madcatse/snark-barker/dxf/SnarkBarker-Edge_Cuts.dxf

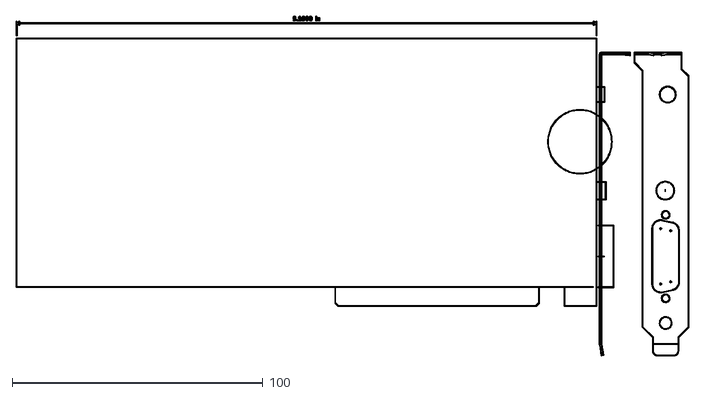
[picture p1: CAD file, 2024-10-25]
dxf/SnarkBarker-Edge_Cuts.dxf
268.1 x 135.3
