madcatse/snark-barker/SnarkBarker.kicad_pcb

## KiCad design SnarkBarker.kicad_pcb (2026-02-19)

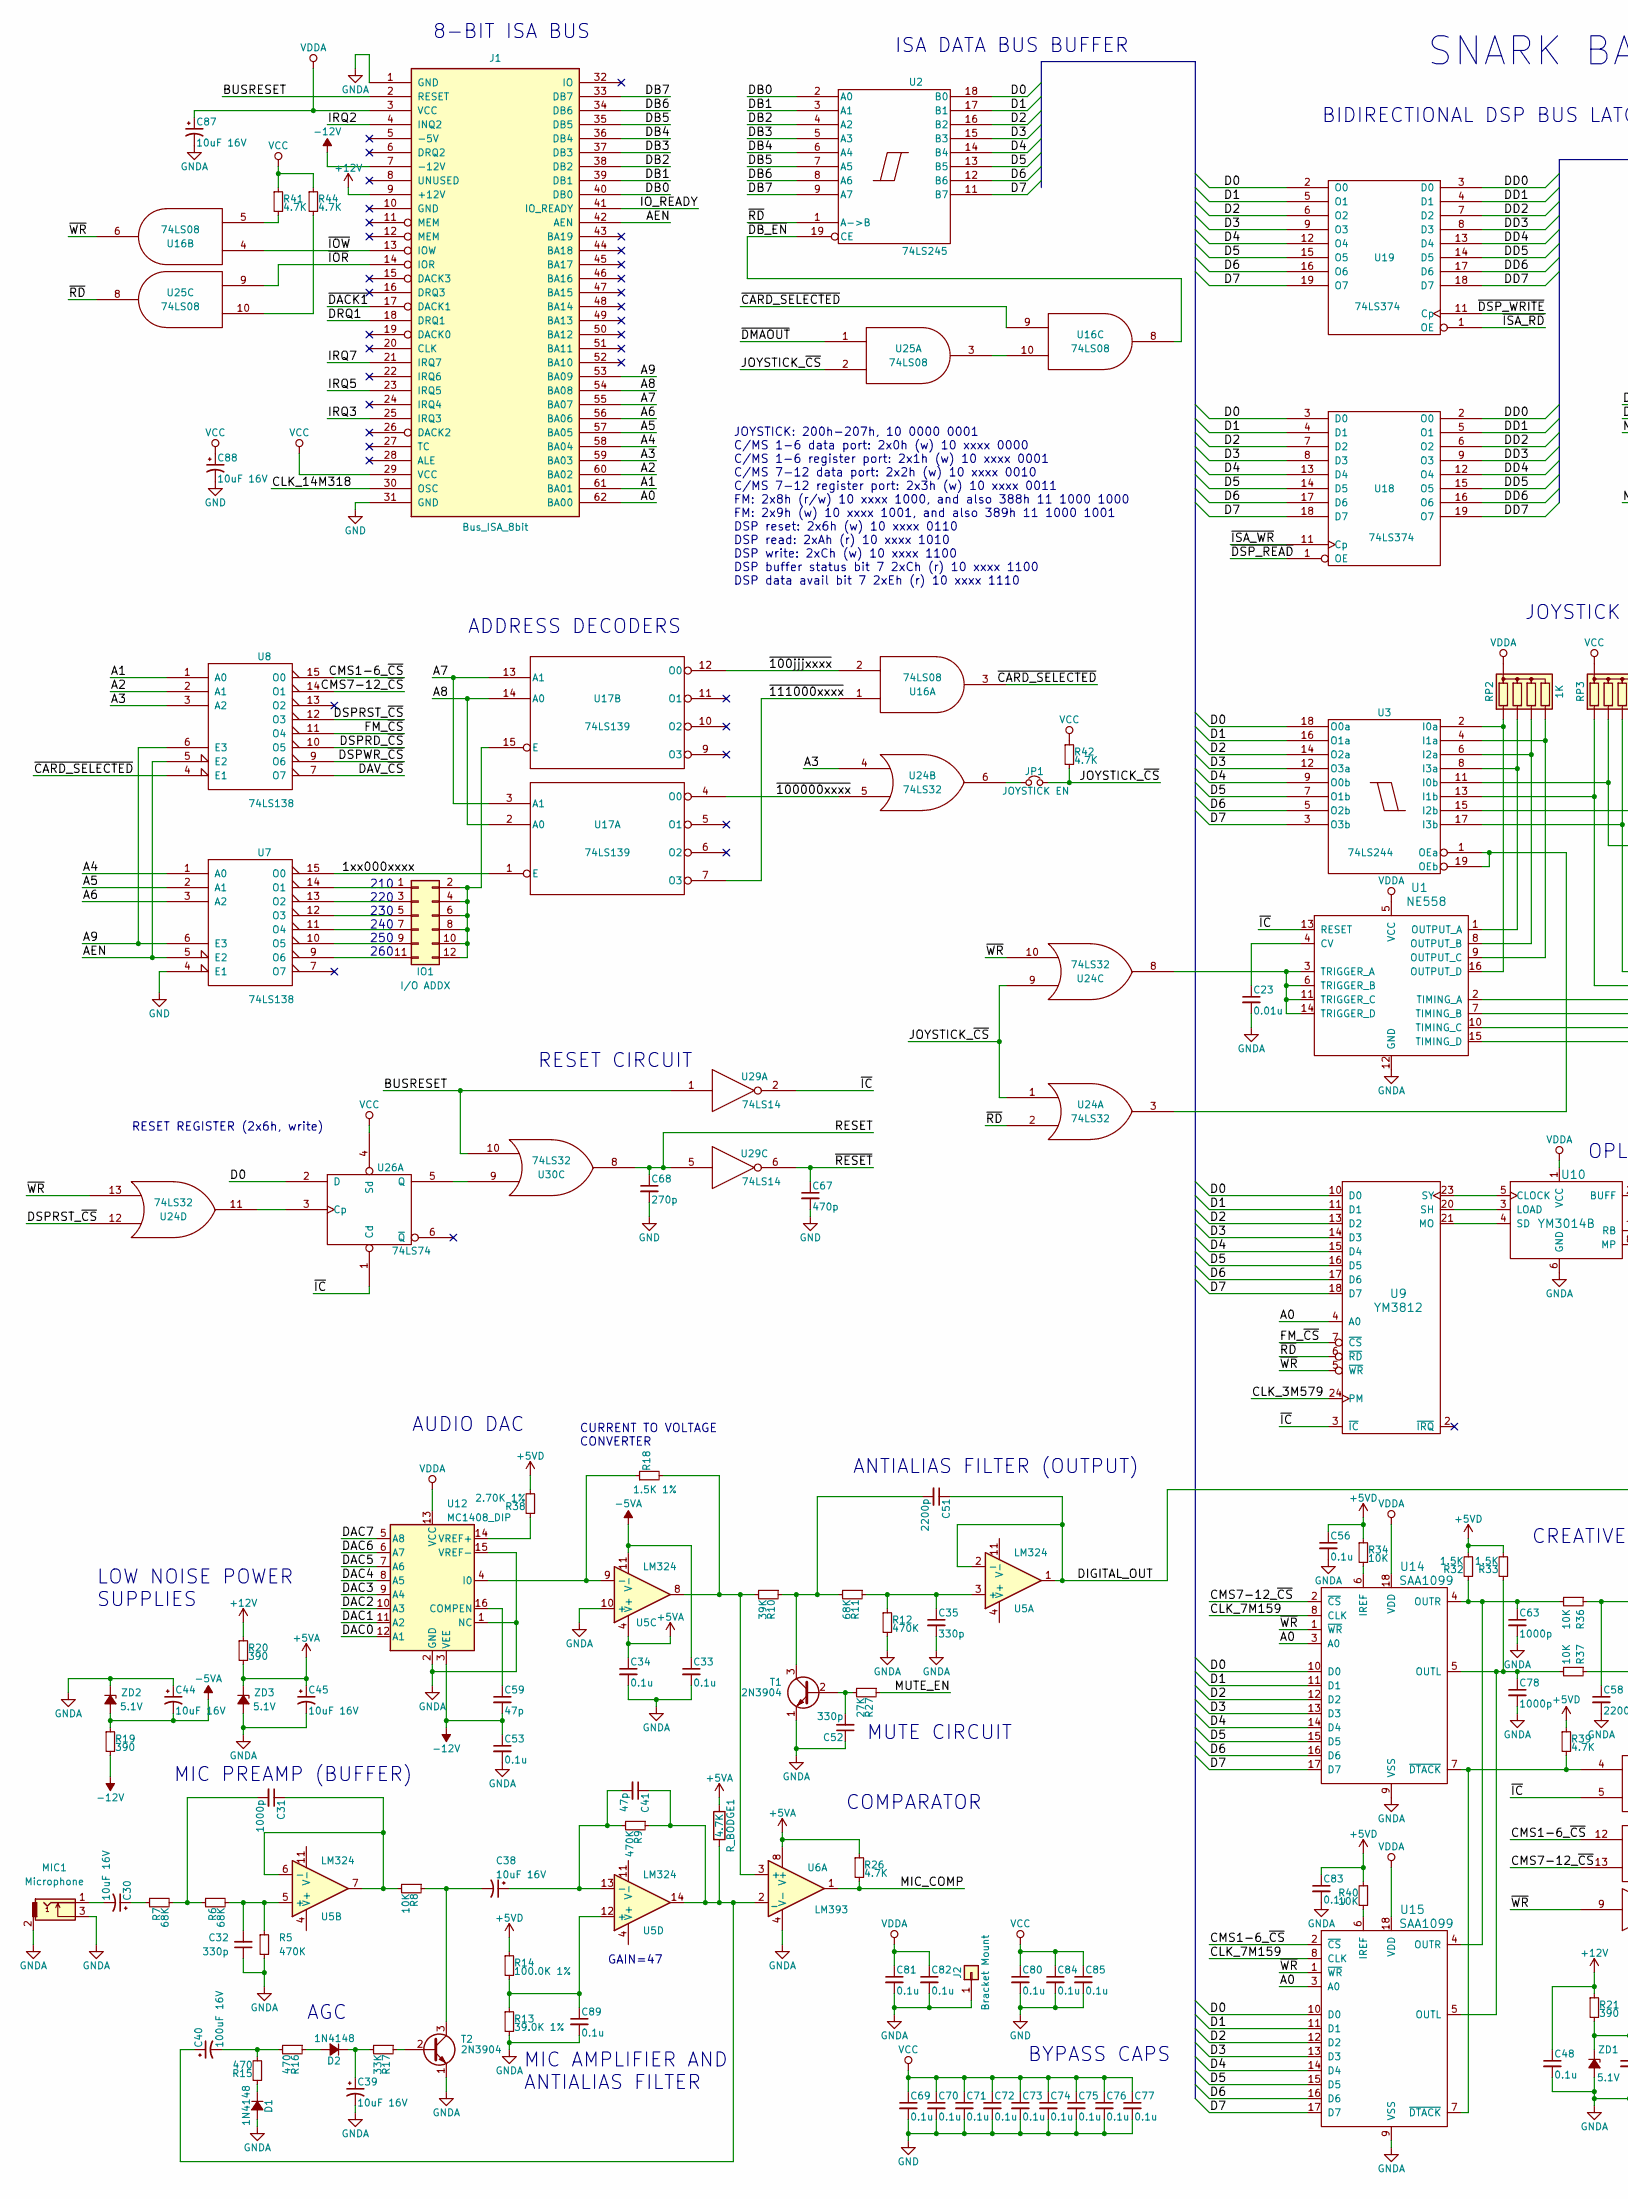
[picture p2: schematic SnarkBarker.kicad_sch, part in row 1, column 1]

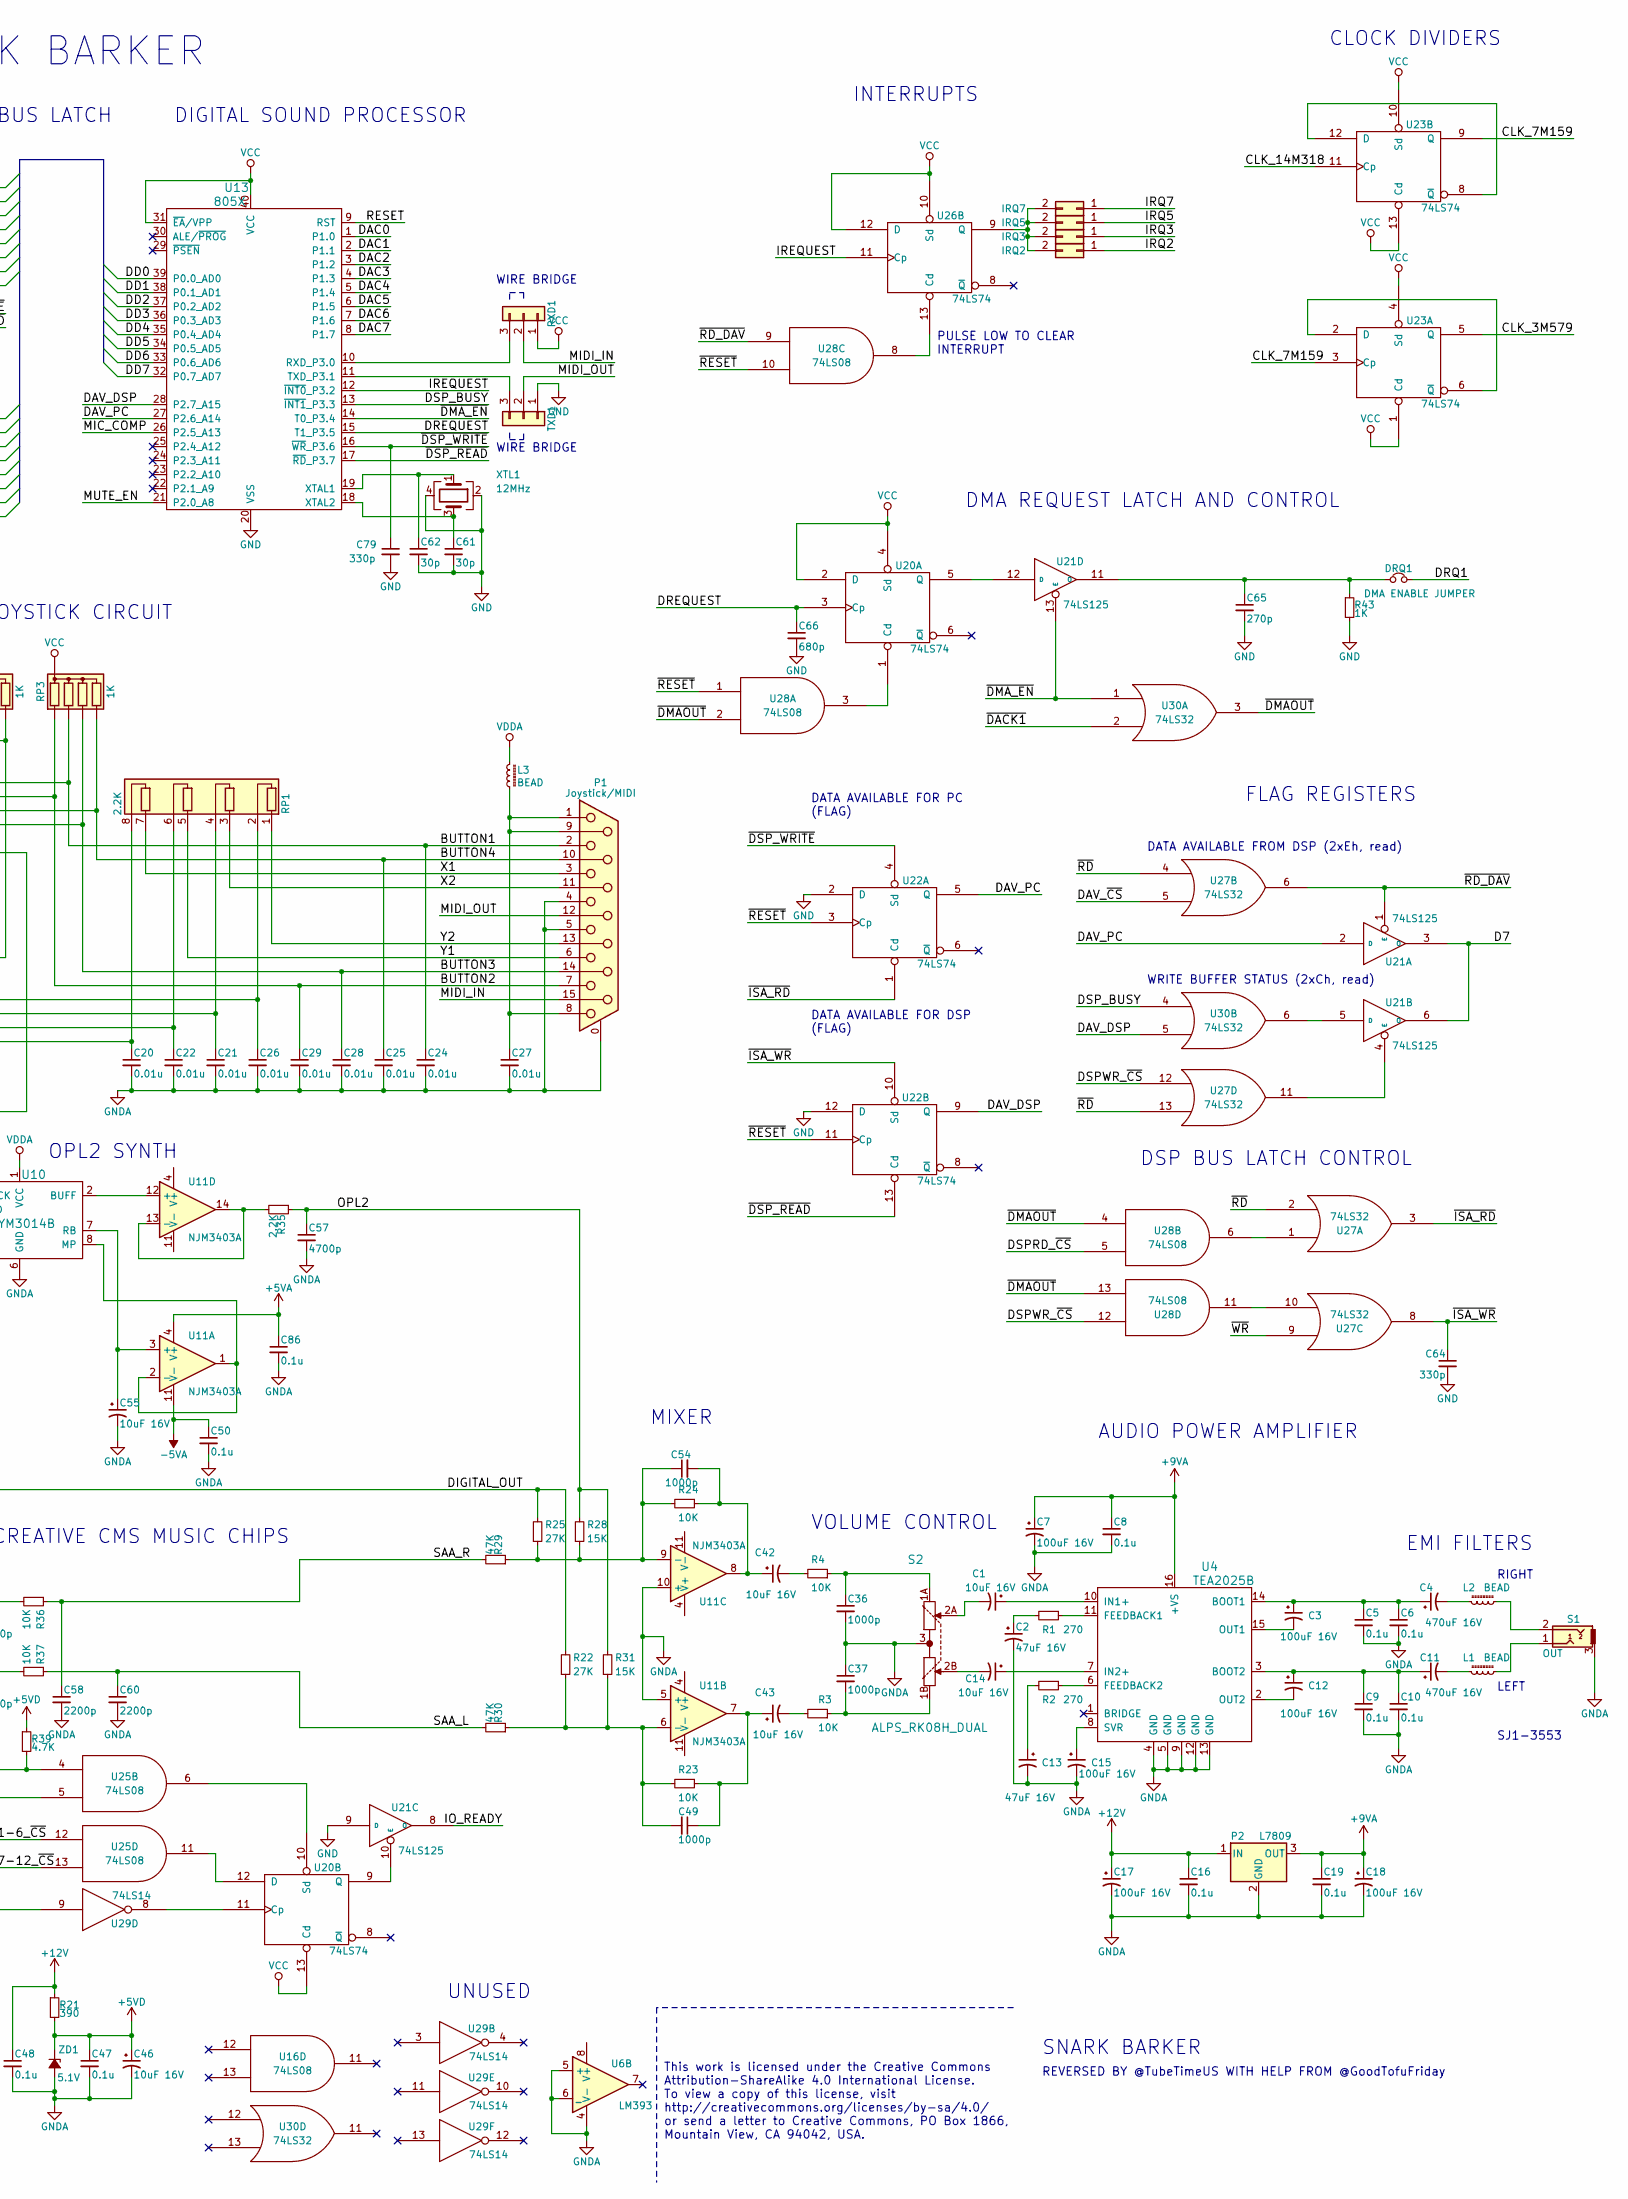
[picture p3: schematic SnarkBarker.kicad_sch, part in row 1, column 2]

Parts:
C1, C14, C30, C38, C39, C42, C43, C44, C45, C46, C55, C87, C88: 10uF 16V; SB_C_RADIAL_75_150; Mouser 667-ECA-1CM100I
C2, C13: 47uF 16V; SB_C_RADIAL_75_150; Mouser 667-ECA-1CM470I
C3, C7, C12, C15, C17, C18, C40: 100uF 16V; SB_C_RADIAL_100_320; Mouser 667-ECA-1CM101I
C4, C11: 470uF 16V; SB_C_RADIAL_100_320; Mouser 667-ECA-1CM471B
C5, C6, C8, C9, C10, C16, C19, C33, C34, C47, C48, C50, C53, C56, C69, C70, C71, C72, C73, C74, C75, C76, C77, C80, C81, C82, C83, C84, C85, C86, C89: 0.1u; SB_C_AXIAL_275; Mouser 581-SA105E104M
C20, C21, C22, C23, C24, C25, C26, C27, C28, C29: 0.01u; SB_C_DISC_200; Mouser 810-FG28X7R1H103KNT0
C31, C36, C37, C49, C54, C63, C78: 1000p; SB_C_DISC_200; Mouser 810-FG28X7R1H102KNT6
C32, C35, C52, C64, C79: 330p; SB_C_DISC_200; Mouser 810-FG28C0G1H331JNT6
C41, C59: 47p; SB_C_DISC_200; Mouser 810-FG28C0G1H470JNT6
C51, C58, C60: 2200p; SB_C_DISC_200; Mouser 810-FG28X7R1H222KNT6
C57: 4700p; SB_C_DISC_200; Mouser 810-FG28C0G1H472JNT6
C61, C62: 30p; SB_C_DISC_200; Mouser 810-FG28C0G1H270JNT6
C65, C68: 270p; SB_C_DISC_200; Mouser 810-FG28C0G1H271JNT0
C66: 680p; SB_C_DISC_200; Mouser 810-FG28C0G1H681JNT6
C67: 470p; SB_C_DISC_200; Mouser 810-FG28C0G1H471JNT6
D1, D2: 1N4148; SB_D_AXIAL_400; Mouser 512-1N4148
DRQ1: DMA ENABLE JUMPER; SB_HDR_1X2
IO1: I/O ADDX; SB_HDR_2X6
IRQ2, IRQ3, IRQ5, IRQ7: Conn_02x01; SB_HDR_1X2
J1: Bus_ISA_8bit; BUS_PC
J2: Bracket Mount; SB_MH_125; Mouser 534-9200
JP1: JOYSTICK EN; SB_HDR_1X2
L1, L2, L3: BEAD; SB_L_AXIAL_500; Mouser 623-2743004111
MIC1: Microphone; SB_MJ-3536N; Mouser 490-MJ-3536N
P1: Joystick/MIDI; SB_DB15_152-3415; Mouser 1636-182-015-213R53
P2: L7809; SB_TO220; Mouser 511-L7809CV
R1, R2: 270; SB_R_AXIAL_400; Mouser 603-CFR-25JB-52-270R
R3, R4, R8, R23, R24, R34, R36, R37, R40: 10K; SB_R_AXIAL_400; Mouser 603-CFR-25JB-52-10K
R5, R9, R12: 470K; SB_R_AXIAL_400; Mouser 603-CFR-25JR-52470K
R6, R7, R11: 68K; SB_R_AXIAL_400; Mouser 603-CFR-25JB-52-68K
R10: 39K; SB_R_AXIAL_400; Mouser 603-CFR-25JB-52-39K
R13: 39.0K 1%; SB_R_AXIAL_400; Mouser 603-MFR-25FBF52-39K
R14: 100.0K 1%; SB_R_AXIAL_400; Mouser 603-MFR-25FBF52-100K
R15, R16: 470; SB_R_AXIAL_400; Mouser 603-CFR-25JB-52-470R
R17: 33K; SB_R_AXIAL_400; Mouser 603-CFR-25JB-52-33K
R18: 1.5K 1%; SB_R_AXIAL_400; Mouser 603-MFR-25FBF52-1K5
R19, R20, R21: 390; SB_R_AXIAL_400; Mouser 603-CFR-25JB-52-390R
R22, R25, R27: 27K; SB_R_AXIAL_400; Mouser 603-CFR-25JB-52-27K
R26, R39, R41, R42, R44: 4.7K; SB_R_AXIAL_400; Mouser 603-CFR-25JB-52-4K7
R28, R31: 15K; SB_R_AXIAL_400; Mouser 603-CFR-25JB-52-15K
R29, R30: 47K; SB_R_AXIAL_400; Mouser 603-CFR-25JB-52-47K
R32, R33: 1.5K; SB_R_AXIAL_400; Mouser 603-CFR-25JB-52-1K5
R35: 2.2K; SB_R_AXIAL_400; Mouser 603-CFR-25JB-52-2K2
R38: 2.70K 1%; SB_R_AXIAL_400; Mouser 603-MFR-25FBF52-2K7
R43: 1K; SB_R_AXIAL_400; Mouser 603-CFR-25JR-521K
RP1: 2.2K; SB_RP_4B; Mouser 652-4608X-AP2-222LF
RP2, RP3: 1K; SB_RP_4C; Mouser 652-4605X-AP1-102LF
RXD1: Conn_01x03; SB_HDR_1X3
R_BODGE1: 4.7K; Mouser 603-CFR-25JB-52-4K7
S1: OUT; SB_SJ1-3553; Mouser 490-SJ1-3553NG
S2: ALPS_RK08H_DUAL; SB_ALPS_RK08_DUAL; Mouser 688-RK08H12100F3
T1, T2: 2N3904; SB_TO92; Mouser 833-2N3904-AP
TXD1: Conn_01x03; SB_HDR_1X3
U1: NE558; SB_DIP16_300
U2: 74LS245; SB_DIP20_300; Mouser 595-SN74LS245N
U3: 74LS244; SB_DIP20_300; Mouser 595-SN74LS244N
U4: TEA2025B; SB_DIP16_300
U5: LM324; SB_DIP14_300; Mouser 595-LM324AN
U6: LM393; SB_DIP8_300; Mouser 595-LM393P
U7, U8: 74LS138; SB_DIP16_300; Mouser 595-SN74LS138NE4
U9: YM3812; SB_DIP24_600
U10: YM3014B; SB_DIP8_300
U11: NJM3403A; SB_DIP14_300; Mouser 513-NJM3403AD
U12: MC1408_DIP; SB_DIP16_300; Mouser 926-DAC0808LCN/NOPB
U13: 805X; SB_DIP40_600; Mouser 556-A89S51-24PU
U14, U15: SAA1099; SB_DIP18_300
U16, U25, U28: 74LS08; SB_DIP14_300; Mouser 595-SN74LS08N
U17: 74LS139; SB_DIP16_300; Mouser 595-SN74LS139AN
U18, U19: 74LS374; SB_DIP20_300; Mouser 595-SN74LS374N
U20, U22, U23, U26: 74LS74; SB_DIP14_300; Mouser 595-SN74LS74AN
U21: 74LS125; SB_DIP14_300; Mouser 595-SN74LS125AN
U24, U27, U30: 74LS32; SB_DIP14_300; Mouser 595-SN74LS32N
U29: 74LS14; SB_DIP14_300; Mouser 595-SN74LS14N
XTL1: 12MHz; SB_XTAL_HC49U_RA; Mouser 815-AB-12-B2
ZD1, ZD2, ZD3: 5.1V; SB_D_AXIAL_400_ALT; Mouser 78-1N5231B-TAP

Connections:
+5VA: C34.1, C45.1, C86.1, R20.2, R26.1, R_BODGE1.1, U5.4 (V+), U6.8 (V+), U11.4 (V+), ZD3.1 (K)
+5VD: C46.1, C47.1, C56.1, C83.1, R14.1, R21.2, R32.2, R33.2, R34.1, R38.2, R39.1, R40.1, ZD1.1 (K)
+9VA: C7.1, C8.1, C18.1, C19.1, P2.3 (OUT), U4.16 (+VS)
+12V: C16.1, C17.1, C48.1, J1.9 (+12V), P2.1 (IN), R20.1, R21.1
-5VA: C33.1, C44.2, C50.1, R19.1, U5.11 (V-), U11.11 (V-), ZD2.2 (A)
-12V: C53.1, C59.2, J1.7 (-12V), R19.2, U12.3 (VEE)
/1xx000xxxx: U7.15 (O0), U17.1 (E)
/A0: J1.62 (BA00), U9.4 (A0), U14.3 (A0), U15.3 (A0)
/A1: J1.61 (BA01), U8.1 (A0)
/A2: J1.60 (BA02), U8.2 (A1)
/A3: J1.59 (BA03), U8.3 (A2), U24.4
/A4: J1.58 (BA04), U7.1 (A0)
/A5: J1.57 (BA05), U7.2 (A1)
/A6: J1.56 (BA06), U7.3 (A2)
/A7: J1.55 (BA07), U17.3 (A1), U17.13 (A1)
/A8: J1.54 (BA08), U17.2 (A0), U17.14 (A0)
/A9: J1.53 (BA09), U7.6 (E3), U8.6 (E3)
/AEN: J1.42 (AEN), U7.5 (E2), U8.5 (E2)
/BUSRESET: J1.2 (RESET), U29.1, U30.10
/BUTTON1: C24.1, P1.2, RP3.3 (R2), U3.11 (I0b)
/BUTTON2: C29.1, P1.7, RP3.2 (R1), U3.13 (I1b)
/BUTTON3: C28.1, P1.14, RP3.4 (R3), U3.17 (I3b)
/BUTTON4: C25.1, P1.10, RP3.5 (R4), U3.15 (I2b)
/CLK_3M579: U9.24 (PM), U23.5 (Q)
/CLK_7M159: U14.8 (CLK), U15.8 (CLK), U23.3 (Cp), U23.9 (Q)
/CLK_14M318: J1.30 (OSC), U23.11 (Cp)
/CMS1-6_~CS: U8.15 (O0), U15.2 (~CS), U25.12
/CMS7-12_~CS: U8.14 (O1), U14.2 (~CS), U25.13
/D0: U2.18 (B0), U3.18 (O0a), U9.10 (D0), U14.10 (D0), U15.10 (D0), U18.3 (D0), U19.2 (O0), U26.2 (D)
/D1: U2.17 (B1), U3.16 (O1a), U9.11 (D1), U14.11 (D1), U15.11 (D1), U18.4 (D1), U19.5 (O1)
/D2: U2.16 (B2), U3.14 (O2a), U9.13 (D2), U14.12 (D2), U15.12 (D2), U18.7 (D2), U19.6 (O2)
/D3: U2.15 (B3), U3.12 (O3a), U9.14 (D3), U14.13 (D3), U15.13 (D3), U18.8 (D3), U19.9 (O3)
/D4: U2.14 (B4), U3.9 (O0b), U9.15 (D4), U14.14 (D4), U15.14 (D4), U18.13 (D4), U19.12 (O4)
/D5: U2.13 (B5), U3.7 (O1b), U9.16 (D5), U14.15 (D5), U15.15 (D5), U18.14 (D5), U19.15 (O5)
/D6: U2.12 (B6), U3.5 (O2b), U9.17 (D6), U14.16 (D6), U15.16 (D6), U18.17 (D6), U19.16 (O6)
/D7: U2.11 (B7), U3.3 (O3b), U9.18 (D7), U14.17 (D7), U15.17 (D7), U18.18 (D7), U19.19 (O7), U21.3 (O), U21.6 (O)
/DAC0: U12.12 (A1), U13.1 (P1.0)
/DAC1: U12.11 (A2), U13.2 (P1.1)
/DAC2: U12.10 (A3), U13.3 (P1.2)
/DAC3: U12.9 (A4), U13.4 (P1.3)
/DAC4: U12.8 (A5), U13.5 (P1.4)
/DAC5: U12.7 (A6), U13.6 (P1.5)
/DAC6: U12.6 (A7), U13.7 (P1.6)
/DAC7: U12.5 (A8), U13.8 (P1.7)
/DAV_DSP: U13.28 (P2.7_A15), U22.9 (Q), U30.5
/DAV_PC: U13.27 (P2.6_A14), U21.2 (D), U22.5 (Q)
/DAV_~CS: U8.7 (O7), U27.5
/DB0: J1.40 (DB0), U2.2 (A0)
/DB1: J1.39 (DB1), U2.3 (A1)
/DB2: J1.38 (DB2), U2.4 (A2)
/DB3: J1.37 (DB3), U2.5 (A3)
/DB4: J1.36 (DB4), U2.6 (A4)
/DB5: J1.35 (DB5), U2.7 (A5)
/DB6: J1.34 (DB6), U2.8 (A6)
/DB7: J1.33 (DB7), U2.9 (A7)
/DD0: U13.39 (P0.0_AD0), U18.2 (O0), U19.3 (D0)
/DD1: U13.38 (P0.1_AD1), U18.5 (O1), U19.4 (D1)
/DD2: U13.37 (P0.2_AD2), U18.6 (O2), U19.7 (D2)
/DD3: U13.36 (P0.3_AD3), U18.9 (O3), U19.8 (D3)
/DD4: U13.35 (P0.4_AD4), U18.12 (O4), U19.13 (D4)
/DD5: U13.34 (P0.5_AD5), U18.15 (O5), U19.14 (D5)
/DD6: U13.33 (P0.6_AD6), U18.16 (O6), U19.17 (D6)
/DD7: U13.32 (P0.7_AD7), U18.19 (O7), U19.18 (D7)
/DIGITAL_OUT: C51.1, R22.2, R25.2, U5.1, U5.2 (-)
/DREQUEST: C66.1, U13.15 (T1_P3.5), U20.3 (Cp)
/DRQ1: DRQ1.2, J1.18 (DRQ1)
/DSPRD_~CS: U8.10 (O5), U28.5
/DSPRST_~CS: U8.12 (O3), U24.12
/DSPWR_~CS: U8.9 (O6), U27.12, U28.12
/DSP_BUSY: U13.13 (~INT1_P3.3), U30.4
/FM_~CS: U8.11 (O4), U9.7 (~CS)
/IO_READY: J1.41 (IO_READY), U21.8 (O)
/IREQUEST: U13.12 (~INT0_P3.2), U26.11 (Cp)
/IRQ2: IRQ2.1, J1.4 (INQ2)
/IRQ3: IRQ3.1, J1.25 (IRQ3)
/IRQ5: IRQ5.1, J1.23 (IRQ5)
/IRQ7: IRQ7.1, J1.21 (IRQ7)
/JOYSTICK_~CS: JP1.2, R42.2, U24.1, U24.9, U25.2
/MIC_COMP: R26.2, U6.1, U13.26 (P2.5_A13)
/MIDI_IN: P1.15, RXD1.2
/MIDI_OUT: P1.12, TXD1.2
/MUTE_EN: R27.1, U13.21 (P2.0_A8)
/OPL2: C57.1, R28.2, R31.2, R35.1
/RESET: C68.1, U13.9 (RST), U29.5, U30.8
/SAA_L: C60.1, R30.2, R37.1
/SAA_R: C58.1, R29.2, R36.1
/X1: P1.3, RP1.7 (R4.1)
/X2: P1.11 (P111), RP1.3 (R2.1)
/Y1: P1.6, RP1.5 (R3.1)
/Y2: P1.13, RP1.1 (R1.1)
/~100jjjxxxx: U16.2, U17.12 (O0)
/~100000xxxx: U17.4 (O0), U24.5
/~111000xxxx: U16.1, U17.7 (O3)
/~CARD_SELECTED: U8.4 (E1), U16.3, U16.9
/~DACK1: J1.17 (DACK1), U30.2
/~DB_EN: U2.19 (CE), U16.8
/~DMAOUT: U25.1, U28.2, U28.4, U28.13, U30.3
/~DMA_EN: U13.14 (T0_P3.4), U21.13 (E), U30.1
/~DSP_READ: U13.17 (~RD_P3.7), U18.1 (OE), U22.13 (Cd)
/~DSP_WRITE: C79.1, U13.16 (~WR_P3.6), U19.11 (Cp), U22.4 (Sd)
/~IC: U1.13 (RESET), U9.3 (~IC), U25.5, U26.1 (Cd), U29.2
/~IOR: J1.14 (IOR), U25.9
/~IOW: J1.13 (IOW), U16.4
/~ISA_RD: U19.1 (OE), U22.1 (Cd), U27.3
/~ISA_WR: C64.1, U18.11 (Cp), U22.10 (Sd), U27.8
/~RD_DAV: U21.1 (E), U27.6, U28.9
/~RD: U2.1 (A->B), U9.6 (~RD), U24.2, U25.8, U27.2, U27.4, U27.13
/~RESET: C67.1, U22.3 (Cp), U22.11 (Cp), U28.1, U28.10, U29.6
/~WR: U9.5 (~WR), U14.1 (~WR), U15.1 (~WR), U16.6, U24.10, U24.13, U27.9, U29.9
GND: C61.2, C62.2, C64.2, C65.2, C66.2, C67.2, C68.2, C69.2, C70.2, C71.2, C72.2, C73.2, C74.2, C75.2, C76.2, C77.2, C79.2, C80.2, C84.2, C85.2, C88.2, J1.31 (GND), R43.2, TXD1.1, U2.10 (GND), U3.10 (GND), U7.4 (E1), U7.8 (GND), U8.8 (GND), U9.12 (GND), U13.20 (VSS), U16.7 (GND), U17.8 (GND), U18.10 (GND), U19.10 (GND), U20.7 (GND), U21.7 (GND), U21.9 (D), U22.2 (D), U22.7 (GND), U22.12 (D), U23.7 (GND), U24.7 (GND), U25.7 (GND), U26.7 (GND), U27.7 (GND), U28.7 (GND), U29.7 (GND), U30.7 (GND), XTL1.2, XTL1.4
GNDA: C2.2, C5.2, C6.2, C7.2, C8.2, C9.2, C10.2, C13.2, C15.2, C16.2, C17.2, C18.2, C19.2, C20.2, C21.2, C22.2, C23.2, C24.2, C25.2, C26.2, C27.2, C28.2, C29.2, C32.1, C33.2, C34.2, C35.2, C36.2, C37.1, C39.2, C44.1, C45.2, C46.2, C47.2, C48.2, C50.2, C52.1, C53.2, C55.2, C56.2, C57.2, C58.2, C60.2, C63.2, C78.2, C81.2, C82.2, C83.2, C86.2, C87.2, C89.2, D1.2 (A), J1.1 (GND), J2.1, MIC1.2, MIC1.3, P1.0 (PAD), P1.4, P1.5, P2.2 (GND), R5.2, R12.2, R13.2, S1.3, S2.3, T1.1 (E), T2.1 (E), U1.12 (GND), U4.4 (GND), U4.5 (GND), U4.9 (GND), U4.12 (GND), U4.13 (GND), U5.10 (+), U6.4 (V-), U6.5 (+), U6.6 (_), U10.6 (GND), U11.5 (+), U11.10 (+), U12.1 (NC), U12.2 (GND), U12.15 (VREF-), U14.9 (VSS), U15.9 (VSS), ZD1.2 (A), ZD2.1 (K), ZD3.2 (A)
unnamed: C1.1, U4.10 (IN1+)
unnamed: C1.2, S2.2A
unnamed: C2.1, R1.2
unnamed: C3.1, C4.1, C5.1, C6.1, U4.14 (BOOT1)
unnamed: C3.2, U4.15 (OUT1)
unnamed: C4.2, L2.1
unnamed: C9.1, C10.1, C11.1, C12.1, U4.3 (BOOT2)
unnamed: C11.2, L1.1
unnamed: C12.2, U4.2 (OUT2)
unnamed: C13.1, R2.2
unnamed: C14.1, U4.7 (IN2+)
unnamed: C14.2, S2.2B
unnamed: C15.1, U4.8 (SVR)
unnamed: C20.1, RP1.8 (R4.2), U1.15 (TIMING_D)
unnamed: C21.1, RP1.4 (R2.2), U1.7 (TIMING_B)
unnamed: C22.1, RP1.6 (R3.2), U1.10 (TIMING_C)
unnamed: C23.1, U1.4 (CV)
unnamed: C26.1, RP1.2 (R1.2), U1.2 (TIMING_A)
unnamed: C27.1, L3.2, P1.1, P1.8, P1.9
unnamed: C30.1, R7.1
unnamed: C30.2, MIC1.1
unnamed: C31.1, R8.2, U5.6 (-), U5.7
unnamed: C31.2, R6.1, R7.2
unnamed: C32.2, R5.1, R6.2, U5.5 (+)
unnamed: C35.1, R11.1, R12.1, U5.3 (+)
unnamed: C36.1, R4.1, S2.1A
unnamed: C37.2, R3.1, S2.1B
unnamed: C38.1, C41.2, R9.2, U5.13 (-)
unnamed: C38.2, R8.1, T2.3 (C)
unnamed: C39.1, D2.1 (K), R17.2
unnamed: C40.1, C41.1, R9.1, R_BODGE1.2, U5.14, U6.2 (_)
unnamed: C40.2, R15.2, R16.2
unnamed: C42.1, C54.2, R24.1, U11.8
unnamed: C42.2, R4.2
unnamed: C43.1, C49.1, R23.1, U11.7
unnamed: C43.2, R3.2
unnamed: C49.2, R22.1, R23.2, R30.1, R31.1, U11.6 (-)
unnamed: C51.2, R10.1, R11.2, T1.3 (C)
unnamed: C52.2, R27.2, T1.2 (B)
unnamed: C54.1, R24.2, R25.1, R28.1, R29.1, U11.9 (-)
unnamed: C55.1, U10.7 (RB), U11.3 (+)
unnamed: C59.1, U12.16 (COMPEN)
unnamed: C61.1, U13.18 (XTAL2), XTL1.3
unnamed: C62.1, U13.19 (XTAL1), XTL1.1
unnamed: C63.1, R32.1, R36.2, U14.4 (OUTR), U15.4 (OUTR)
unnamed: C65.1, DRQ1.1, R43.1, U21.11 (O)
unnamed: C78.1, R33.1, R37.2, U14.5 (OUTL), U15.5 (OUTL)
unnamed: C89.1, R13.1, R14.2, U5.12 (+)
unnamed: D1.1 (K), R15.1
unnamed: D2.2 (A), R16.1
unnamed: IO1.1, U7.14 (O1)
unnamed: IO1.3, U7.13 (O2)
unnamed: IO1.5, U7.12 (O3)
unnamed: IO1.7, U7.11 (O4)
unnamed: IO1.9, U7.10 (O5)
unnamed: IO1.2, IO1.4, IO1.6, IO1.8, IO1.10, IO1.12, U17.15 (E)
unnamed: IO1.11, U7.9 (O6)
unnamed: IRQ2.2, IRQ3.2, IRQ5.2, IRQ7.2, U26.9 (Q)
unnamed: JP1.1, U24.6
unnamed: L1.2, S1.1
unnamed: L2.2, S1.2
unnamed: R1.1, U4.11 (FEEDBACK1)
unnamed: R2.1, U4.6 (FEEDBACK2)
unnamed: R10.2, R18.2, U5.8, U6.3 (+)
unnamed: R17.1, T2.2 (B)
unnamed: R18.1, U5.9 (-), U12.4 (I0)
unnamed: R34.2, U14.6 (IREF)
unnamed: R35.2, U11.13 (-), U11.14
unnamed: R38.1, U12.14 (VREF+)
unnamed: R39.2, U14.7 (~DTACK), U15.7 (~DTACK), U25.4
unnamed: R40.2, U15.6 (IREF)
unnamed: R41.2, U16.5
unnamed: R44.2, U25.10
unnamed: RP2.2 (R1), U1.16 (OUTPUT_D), U3.2 (I0a)
unnamed: RP2.3 (R2), U1.1 (OUTPUT_A), U3.8 (I3a)
unnamed: RP2.4 (R3), U1.8 (OUTPUT_B), U3.6 (I2a)
unnamed: RP2.5 (R4), U1.9 (OUTPUT_C), U3.4 (I1a)
unnamed: RXD1.3, U13.10 (RXD_P3.0)
unnamed: TXD1.3, U13.11 (TXD_P3.1)
unnamed: U1.3 (TRIGGER_A), U1.6 (TRIGGER_B), U1.11 (TRIGGER_C), U1.14 (TRIGGER_D), U24.8
unnamed: U10.2 (BUFF), U11.12 (+)
unnamed: U9.20 (SH), U10.3 (LOAD)
unnamed: U9.21 (MO), U10.4 (SD)
unnamed: U9.23 (SY), U10.5 (CLOCK)
unnamed: U10.8 (MP), U11.1, U11.2 (-)
unnamed: U16.10, U25.3
unnamed: U20.1 (Cd), U28.3
unnamed: U20.5 (Q), U21.12 (D)
unnamed: U20.9 (Q), U21.10 (E)
unnamed: U20.10 (Sd), U25.6
unnamed: U20.11 (Cp), U29.8
unnamed: U20.12 (D), U25.11
unnamed: U21.4 (E), U27.11
unnamed: U21.5 (D), U30.6
unnamed: U23.2 (D), U23.6 (~Q)
unnamed: U23.8 (~Q), U23.12 (D)
unnamed: U3.1 (OEa), U3.19 (OEb), U24.3
unnamed: U24.11, U26.3 (Cp)
unnamed: U26.5 (Q), U30.9
unnamed: U26.13 (Cd), U28.8
unnamed: U27.1, U28.6
unnamed: U27.10, U28.11
VCC: C69.1, C70.1, C71.1, C72.1, C73.1, C74.1, C75.1, C76.1, C77.1, C80.1, C84.1, C85.1, C88.1, J1.29 (VCC), R41.1, R42.1, R44.1, RP3.1 (common), RXD1.1, U2.20 (VCC), U3.20 (VCC), U7.16 (VCC), U8.16 (VCC), U9.1 (VCC), U13.31 (~EA/VPP), U13.40 (VCC), U16.14 (VCC), U17.16 (VCC), U18.20 (VCC), U19.20 (VCC), U20.2 (D), U20.4 (Sd), U20.13 (Cd), U20.14 (VCC), U21.14 (VCC), U22.14 (VCC), U23.1 (Cd), U23.4 (Sd), U23.10 (Sd), U23.13 (Cd), U23.14 (VCC), U24.14 (VCC), U25.14 (VCC), U26.4 (Sd), U26.10 (Sd), U26.12 (D), U26.14 (VCC), U27.14 (VCC), U28.14 (VCC), U29.14 (VCC), U30.14 (VCC)
VDDA: C81.1, C82.1, C87.1, J1.3 (VCC), L3.1, RP2.1 (common), U1.5 (VCC), U10.1 (VCC), U12.13 (VCC), U14.18 (VDD), U15.18 (VDD)

Notes on the sheet:
DATA AVAILABLE FOR PC (FLAG)
8-BIT ISA BUS
RIGHT
JOYSTICK CIRCUIT
GAIN=47
DMA REQUEST LATCH AND CONTROL
DIGITAL SOUND PROCESSOR
AGC
DATA AVAILABLE FOR DSP (FLAG)
ADDRESS DECODERS
AUDIO POWER AMPLIFIER
SNARK BARKER
PULSE LOW TO CLEAR INTERRUPT
BYPASS CAPS
MIC PREAMP (BUFFER)
210 220 230 240 250 260
CURRENT TO VOLTAGE CONVERTER
ISA DATA BUS BUFFER
AUDIO DAC
DATA AVAILABLE FROM DSP (2xEh, read)
CREATIVE CMS MUSIC CHIPS
UNUSED
LOW NOISE POWER SUPPLIES
This work is licensed under the Creative Commons Attribution-ShareAlike 4.0 International License. To view a copy of this license, visit http://creativecommons.org/licenses/by-sa/4.0/ or send a letter to Creative Commons, PO Box 1866, Mountain View, CA 94042, USA.
CLOCK DIVIDERS
MIC AMPLIFIER AND ANTIALIAS FILTER
LEFT
WIRE BRIDGE
MIXER
FLAG REGISTERS
RESET REGISTER (2x6h, write)
BIDIRECTIONAL DSP BUS LATCH
ANTIALIAS FILTER (OUTPUT)
DSP BUS LATCH CONTROL
OPL2 SYNTH
WRITE BUFFER STATUS (2xCh, read)
MUTE CIRCUIT
VOLUME CONTROL
REVERSED BY @TubeTimeUS WITH HELP FROM @GoodTofuFriday
EMI FILTERS
SJ1-3553
INTERRUPTS
JOYSTICK: 200h-207h, 10 0000 0001 C/MS 1-6 data port: 2x0h (w) 10 xxxx 0000 C/MS 1-6 register port: 2x1h (w) 10 xxxx 0001 C/MS 7-12 data port: 2x2h (w) 10 xxxx 0010 C/MS 7-12 register port: 2x3h (w) 10 xxxx 0011 FM: 2x8h (r/w) 10 xxxx 1000, and also 388h 11 1000 1000 FM: 2x9h (w) 10 xxxx 1001, and 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
COMPARATOR
RESET CIRCUIT

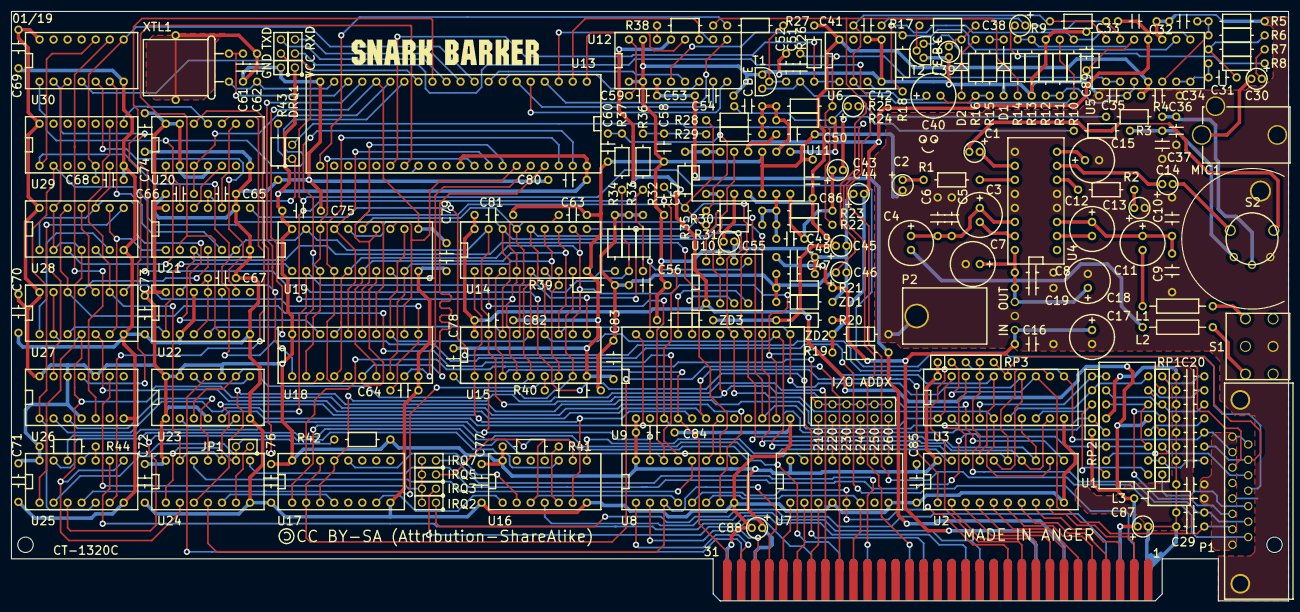
[picture p4: board SnarkBarker.kicad_pcb from above]

Board: 2 copper layers, 231.1 x 106.7 mm, 193 parts (0 on the bottom side), 215 nets.
