madcatse/snark-barker/(notices)

Notices in the files:
SnarkBarker.kicad_pcb:
Copyright (C) 2018 Eric Schlaepfer
License. See https://creativecommons.org/licenses/by-sa/4.0
This work is licensed under a Creative Commons Attribution-ShareAlike 4.0 International
CC BY-SA (Attribution-ShareAlike)
